genius1998/balance-bot/BalanceBot_F446ZE.ioc

Mcu.UserName=STM32F446ZETx
PA10.GPIO_Label=USB_ID
PA10.Signal=USB_OTG_FS_ID
PA11.GPIO_Label=USB_DM
PA11.Signal=USB_OTG_FS_DM
PA12.GPIO_Label=USB_DP
PA12.Signal=USB_OTG_FS_DP
PA13.GPIO_Label=TMS
PA13.Signal=SYS_JTMS-SWDIO
PA14.GPIO_Label=TCK
PA14.Signal=SYS_JTCK-SWCLK
PA3.GPIO_Label=TB_STBY
PA3.Signal=GPIO_Output
PA8.GPIO_Label=USB_SOF [TP1]
PA8.Signal=USB_OTG_FS_SOF
PA9.GPIO_Label=USB_VBUS
PA9.Signal=USB_OTG_FS_VBUS
PB0.GPIO_Label=LD1 [Green]
PB0.Signal=GPIO_Output
PB14.GPIO_Label=LD3 [Red]
PB14.Signal=GPIO_Output
PB7.GPIO_Label=LD2 [Blue]
PB7.Signal=GPIO_Output
PB8.Signal=I2C1_SCL
PB9.Signal=I2C1_SDA
PC13.GPIO_Label=USER_Btn [B1]
PC13.Signal=GPXTI13
PC14-OSC32_IN.Signal=RCC_OSC32_IN
PC15-OSC32_OUT.Signal=RCC_OSC32_OUT
PD14.Signal=S_TIM4_CH3
PD15.Signal=S_TIM4_CH4
PD8.GPIO_Label=STLK_RX [STM32F103CBT6_PA3]
PD8.Signal=USART3_TX
PD9.GPIO_Label=STLK_TX [STM32F103CBT6_PA2]
PD9.Signal=USART3_RX
PF12.GPIO_Label=MOTOR_BIN2
PF12.Signal=GPIO_Output
PF13.GPIO_Label=MOTOR_BIN1
PF13.Signal=GPIO_Output
PF14.GPIO_Label=MOTOR_AIN2
PF14.Signal=GPIO_Output
PF15.GPIO_Label=MOTOR_AIN1
PF15.Signal=GPIO_Output
PG6.GPIO_Label=USB_PowerSwitchOn [STMPS2151STR_EN]
PG6.Signal=GPIO_Output
PG7.GPIO_Label=USB_OverCurrent [STMPS2151STR_FAULT]
PG7.Signal=GPIO_Input
PH0-OSC_IN.GPIO_Label=MCO [STM32F103CBT6_PA8]
PH0-OSC_IN.Signal=RCC_OSC_IN
PH1-OSC_OUT.Signal=RCC_OSC_OUT
