genius1998/balance-bot/Inc/main.h

#define USER_Btn_Pin GPIO_PIN_13
#define USER_Btn_GPIO_Port GPIOC
#define MCO_Pin GPIO_PIN_0
#define MCO_GPIO_Port GPIOH
#define TB_STBY_Pin GPIO_PIN_3
#define TB_STBY_GPIO_Port GPIOA
#define LD1_Pin GPIO_PIN_0
#define LD1_GPIO_Port GPIOB
#define MOTOR_BIN2_Pin GPIO_PIN_12
#define MOTOR_BIN2_GPIO_Port GPIOF
#define MOTOR_BIN1_Pin GPIO_PIN_13
#define MOTOR_BIN1_GPIO_Port GPIOF
#define MOTOR_AIN2_Pin GPIO_PIN_14
#define MOTOR_AIN2_GPIO_Port GPIOF
#define MOTOR_AIN1_Pin GPIO_PIN_15
#define MOTOR_AIN1_GPIO_Port GPIOF
#define LD3_Pin GPIO_PIN_14
#define LD3_GPIO_Port GPIOB
#define STLK_RX_Pin GPIO_PIN_8
#define STLK_RX_GPIO_Port GPIOD
#define STLK_TX_Pin GPIO_PIN_9
#define STLK_TX_GPIO_Port GPIOD
#define USB_PowerSwitchOn_Pin GPIO_PIN_6
#define USB_PowerSwitchOn_GPIO_Port GPIOG
#define USB_OverCurrent_Pin GPIO_PIN_7
#define USB_OverCurrent_GPIO_Port GPIOG
#define USB_SOF_Pin GPIO_PIN_8
#define USB_SOF_GPIO_Port GPIOA
#define USB_VBUS_Pin GPIO_PIN_9
#define USB_VBUS_GPIO_Port GPIOA
#define USB_ID_Pin GPIO_PIN_10
#define USB_ID_GPIO_Port GPIOA
#define USB_DM_Pin GPIO_PIN_11
#define USB_DM_GPIO_Port GPIOA
#define USB_DP_Pin GPIO_PIN_12
#define USB_DP_GPIO_Port GPIOA
#define TMS_Pin GPIO_PIN_13
#define TMS_GPIO_Port GPIOA
#define TCK_Pin GPIO_PIN_14
#define TCK_GPIO_Port GPIOA
#define LD2_Pin GPIO_PIN_7
#define LD2_GPIO_Port GPIOB
