genius1998/balance-bot/(commit log)

2026-09-16 feat: 엔코더 없는 2륜 밸런싱 동작 (각도 PID, 자동 ARM, I2C 버스 복구)
2026-09-16 docs: README 추가 — 데모 영상·사진, 배선, 제어 구조, 사용법
    - docs/evidence.gif: README에서 바로 재생되는 미리보기
    - docs/evidence.mp4: 브라우저 재생용 H.264 사본 (원본은 HEVC)
    - 스타 접지, I2C 버스 복구, 자동 ARM, 현재 파라미터와 근거 정리
2026-09-16 docs: 영상 링크를 실제 동작(내려받기)에 맞게 수정
    GitHub 파일 뷰어는 레포 안의 mp4를 재생하지 않고 View raw만 제공한다.
    '영상 보기' 링크가 플레이어 없는 페이지로 가던 것을 ?raw=true 직접 다운로드로 바꾸고, GIF가 미리보기 역할임을 명시.
2026-09-20 feat: 엔코더 기반 바퀴 속도 외부 루프와 I2C 진단 추가
    제어
    - TIM3(D12/D11), TIM1(D6/D5) 쿼드러처 엔코더를 balance_bot.c 안에서 직접 초기화.
    CubeMX 재생성이 설정을 지우지 못하게 하고 제어 경로를 한 파일에 모음.
    - 바퀴 속도로 목표각을 보정하는 외부 루프. 속도가 쌓여 최고 RPM에 닿으면
    더 가속할 수 없어 넘어지는 문제를 막는다. 위치는 일부러 제어하지 않음.
    - 보정량 ±3도 제한, 속도에는 느린 저역통과(기본 0.98). 외부 루프가 안쪽
    루프보다 빠르면 로봇 자신의 까딱임을 쫓아다니며 목표각을 흔든다.
    - KV 기본값 0으로 출하.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
